AboKafta/MP3-Player/wiring_diagram (1).png

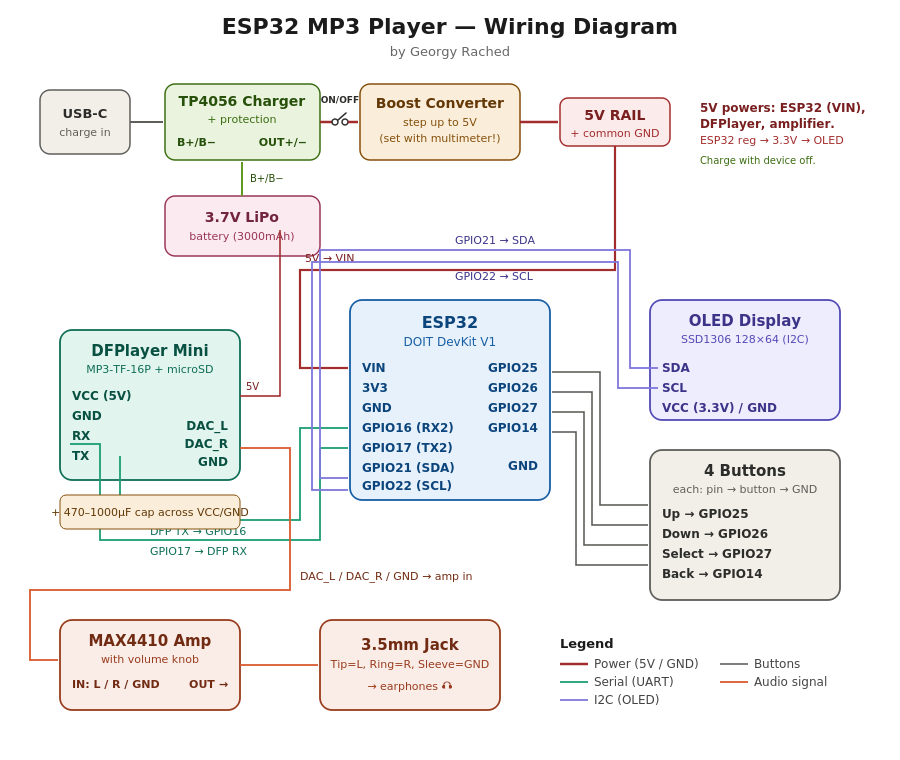
wiring_diagram (1).png
